riasingh2353/team27/docs/about.md

# Gathered close in tenuous firelight, and uneasy companionship.

Let me share with you the terrible wonders I have come to know...

[Home](./index.md)

## Felicia Guo
Felicia asked not to participate in D&D related about page descriptions.

[//]: # (As a level 10 ruiner of fun, Felicia is in the tomes of "Can you not?" and Loud Sighing. She embodies the spirit of the questing party, begrudgingly going along with the requirements of the ECE 3400 quest and the antics of her fellow adventurers.)
<br/>

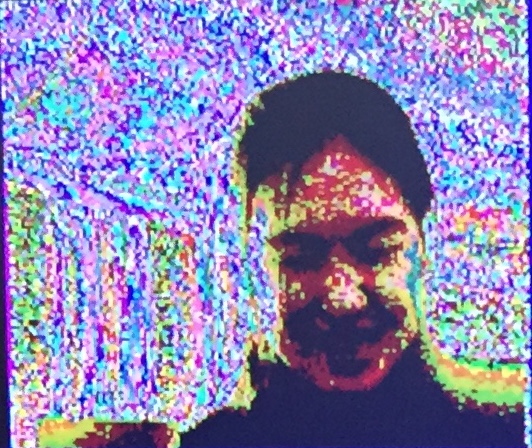
[picture p1: docs/media/about_us/felicia.png]
Felicia
 

## Michael Gong Rivera
NAME: MGGGGGGGGGGGGGGGGGG | ˈem-jēēēēēēēēēēēēēē<br/><br/>
CLASS & TITLE: Elf Sorcerer, ECE Folk Hero<br/><br/>
<!--[//]: # (STATS: Str: Thinks about going to the gym (+4) )
[//]: # (  Dex: 50 WPM (+1)  )
[//]: # (Con: 150lbs +- 10 (-2))
[//]: # (Int: Can this be negative (+pi)  ) 
[//]: # (Wis: Beyond his years (+20)   )
[//]: # (Cha: "unethusiastic...not very helpful...typically ask another TA who is more knowledgeable" (-6)<br/><br/>)
[//]: # (SPELLS: Long-winded Joke, "_Have heard of Stuyvesant?_", Talk to Self<br/><br/>)
[//]: # (FEATURES & TRAITS: Nocturnal, Sarcasm, Masochist, Lack of Impulse Control, Basic Taste<br/><br/>)
[//]: # (WEAKNESSES: Try literally roast, it'll probably stick)
-->
<br/>

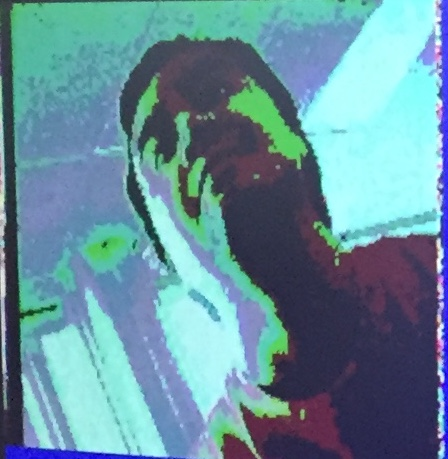
[picture p2: docs/media/about_us/michael.png]
Michael
 

## Ria Singh

<!--[//]: # (For the following, description requires background music to set the ambience.<br/>)
[//]: # (Please open a new tab and play "Duck, Duck, Goose" by Cupcakke (Rated R)<br/>)
[//]: # ((Aside: Don't actually play the song. You'll think less of us afterwards)<br/>)
[//]: # (Don't worry, I'll wait.<br/>)
[//]: # (Ready?<br/>)
[//]: # (Ok.<br/>)
[//]: # (Ria is a wandering bard searching for anyone willing to listen to her shittalk her companions. From objectively the worst state in the country, New Jersey, her abilities include laughing at the anything, as everything is apparently funny. Always one to lighten the hearts of her fellow travelers in times of stress, Ria embodies the mantras of memeing. Whether it be yelling at inanimate objects or forgetting to turn on the power supply, )
-->
Ria always manages to roll a perfect 20 on a d6 and temporarily improve the constitution of her party members by 2.
<br/><br/>
<!--Please finish listening to the song and then consider your life decisions)-->

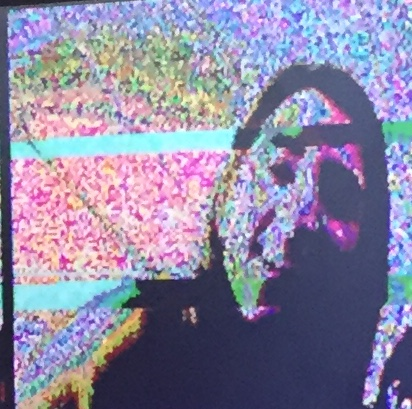
[picture p3: docs/media/about_us/ria.png]
Ria
 

## Ben Taussig

Ben is an elder lich, spawned during the Neoproterozoic Era and skilled in necromancy and aquakinesis. Neglect his warnings at your peril.

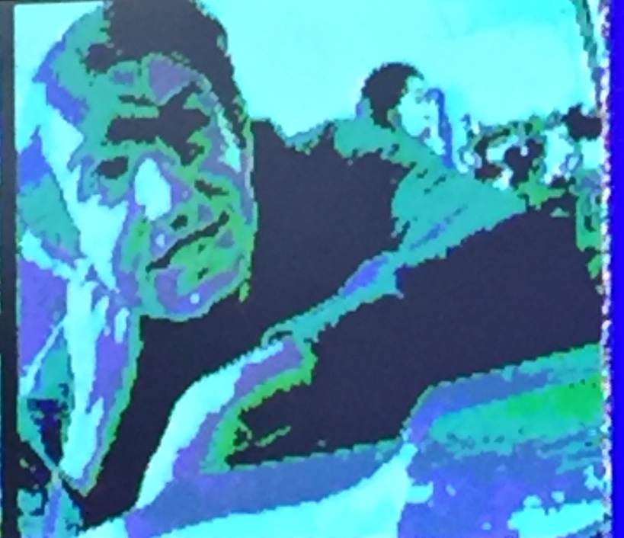
[picture p4: docs/media/about_us/ben.png]
Ben
 

## Ian Power

<!--[//]: # (Ian Power can be described as the diva of the group, the Scary Spice of the respective Girls.  He's fiercly independent, but never fails to be the star of the show.  Nevertheless, even when times get tough and the Cart has been gutted to find a loose wire, he can keep his head on his shoulders and remaining steadfast, like the steady Libyan coast that sheltered Aeneas' crew from Hera's watery wrath.)
-->
<!--
[//]: # (Ian Power is credited with robot documentation on the website, out-of-pocket R&D expenses (currently totalling $4620),)
[//]: # (and paying off TAs to sabotage other teams' cameras in order to pressure Kirstin to push back lab deadlines.  He currently holds the titles of Lead SysAdmin, Supreme Schematic-meister, and the Party Minstrel.  His special skills include playing the Trumpet, uphill skiing, and playing the numbers round in the UK gameshow Countdown.)
-->

Ian Power has never been to Canada, and doesn't believe it really exists.

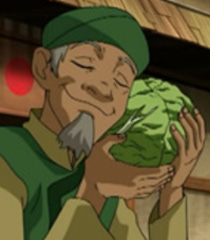
[picture p5: docs/media/about_us/cabbage_man.png]


## Zabiba
<!--[//]: # (A nightmarish creature beyond the control of its creators.)-->

Special Ability: Force all players to make a sanity roll on a d2.
<!--[//]: # (If successful, survive the semester, but receive +10 stress. On failure, cry and change major to CS.)-->

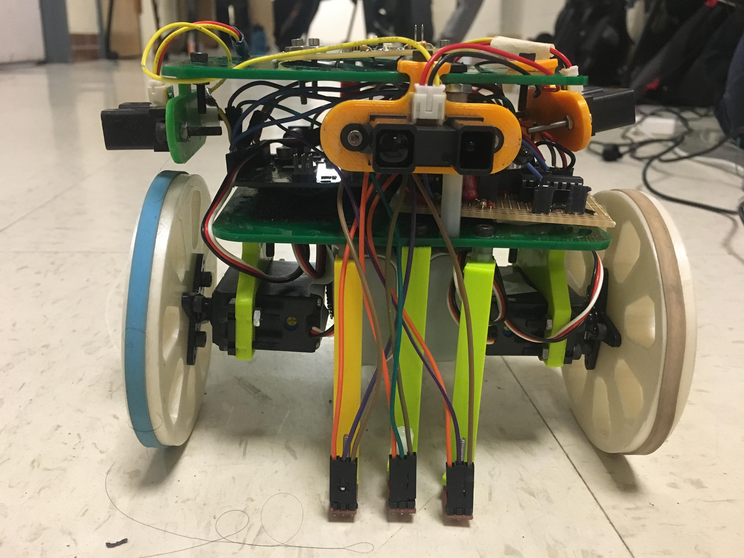
[picture p6: docs/media/final_design/final_design.png]
Final


<br/>
I hope these words steel your convictions for the trials to come.<br/>
Yours Truly,<br/>
-The Narrator
