riasingh2353/team27/Code/milestone3/animation (1).gif

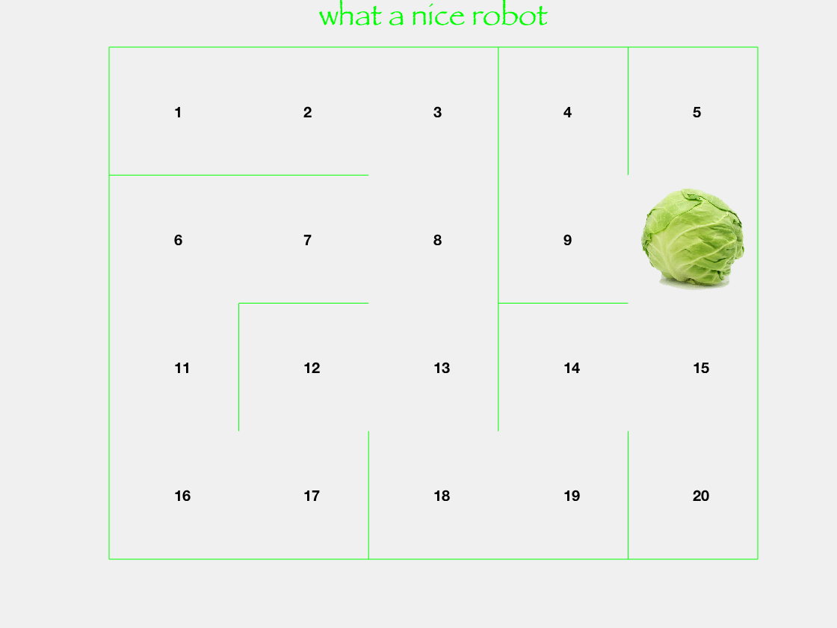
Code/milestone3/animation (1).gif
