riasingh2353/team27/docs/media/analog_read.png

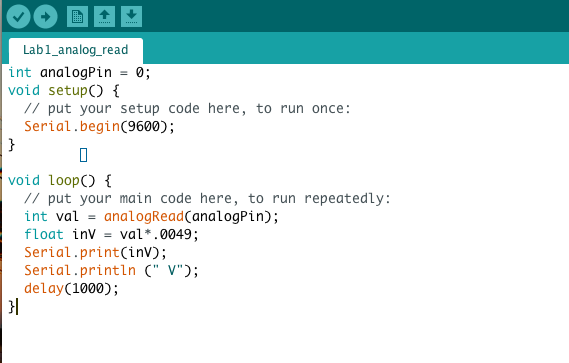
docs/media/analog_read.png
