riasingh2353/team27/docs/media/blink_loop.png

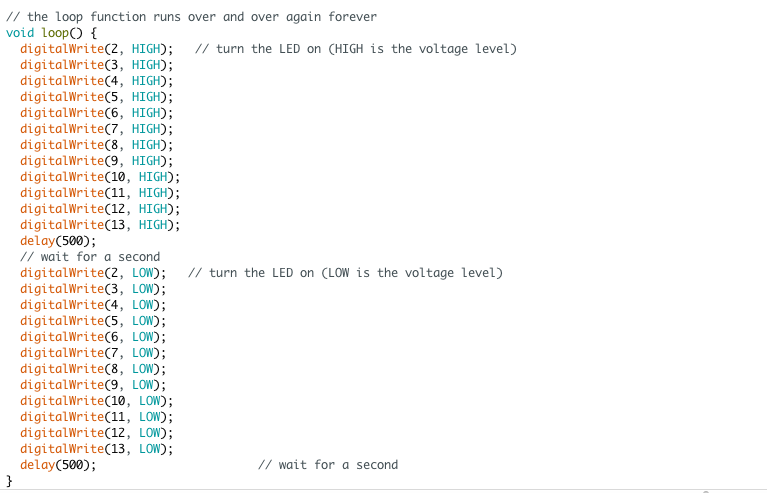
docs/media/blink_loop.png
