riasingh2353/team27/docs/media/FRONTOFROBOT.jpg

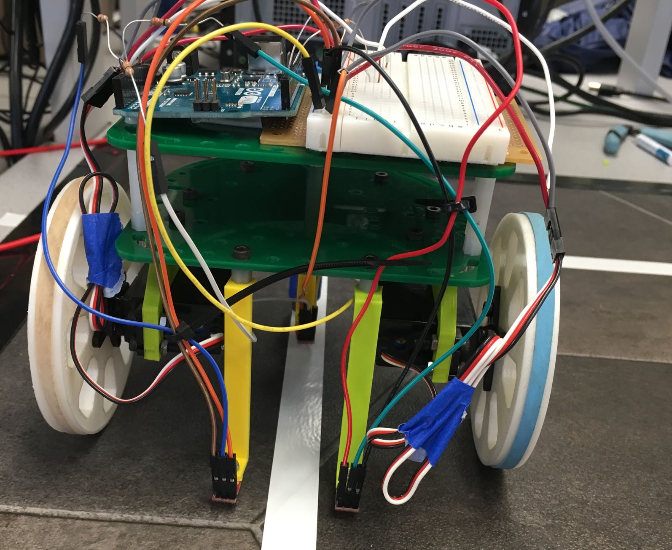
docs/media/FRONTOFROBOT.jpg
