riasingh2353/team27/docs/media/group_pic.png

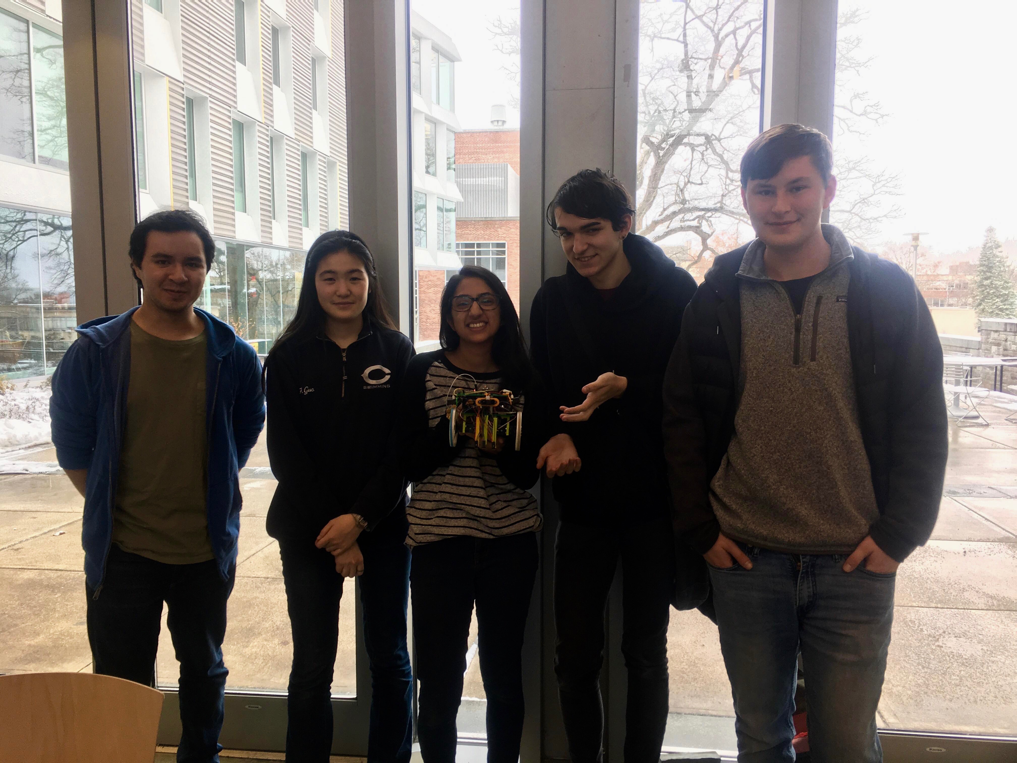
docs/media/group_pic.png
