riasingh2353/team27/docs/media/IMG_2586.PNG

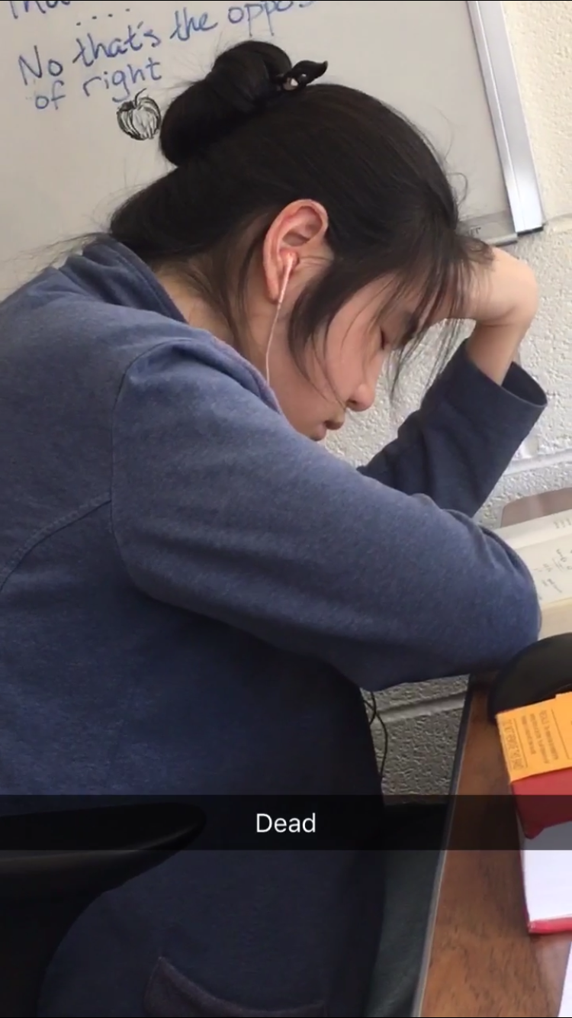
docs/media/IMG_2586.PNG
