riasingh2353/team27/docs/media/IRChart.PNG

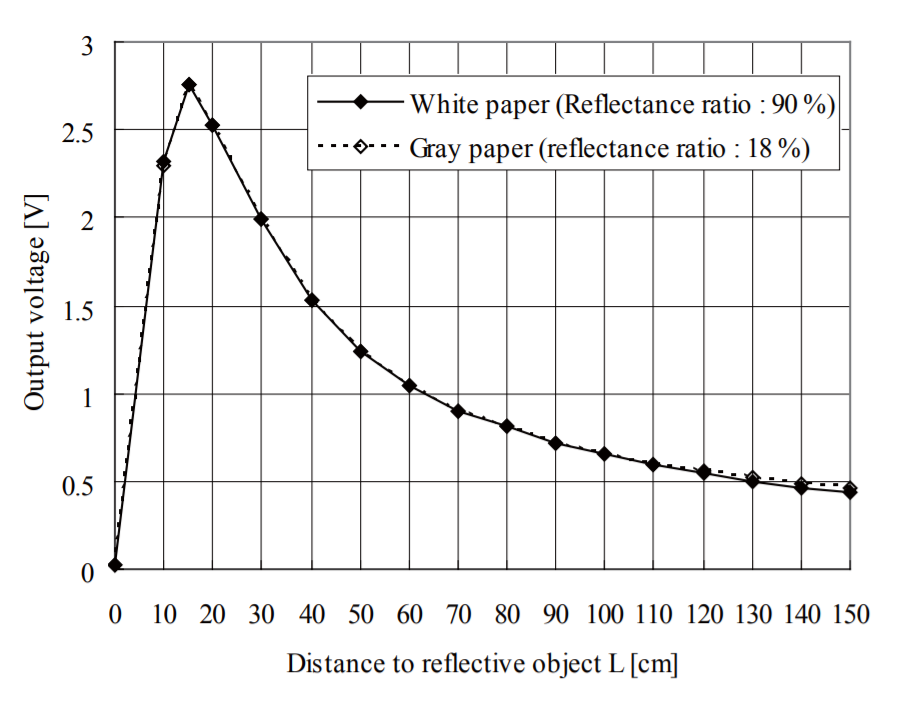
docs/media/IRChart.PNG
