riasingh2353/team27/docs/media/lab2/18khz.png

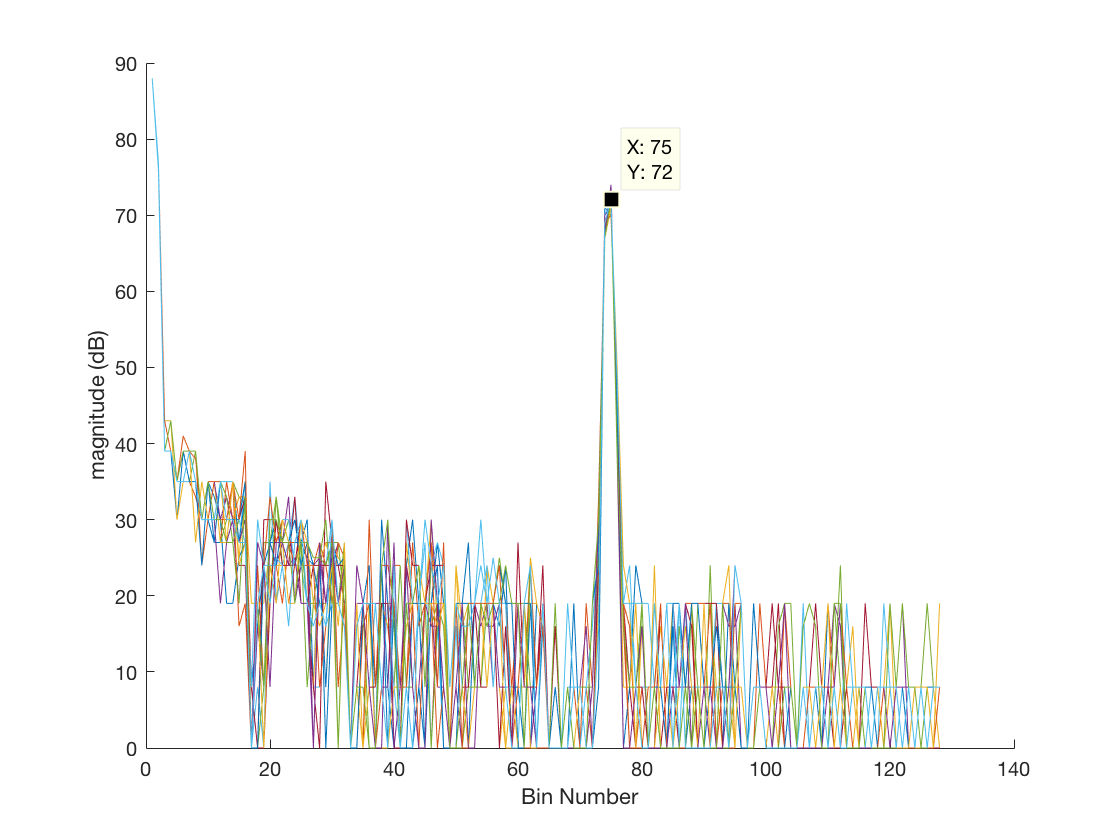
docs/media/lab2/18khz.png
