riasingh2353/team27/docs/media/lab3/Screenshot of radio working properly.png

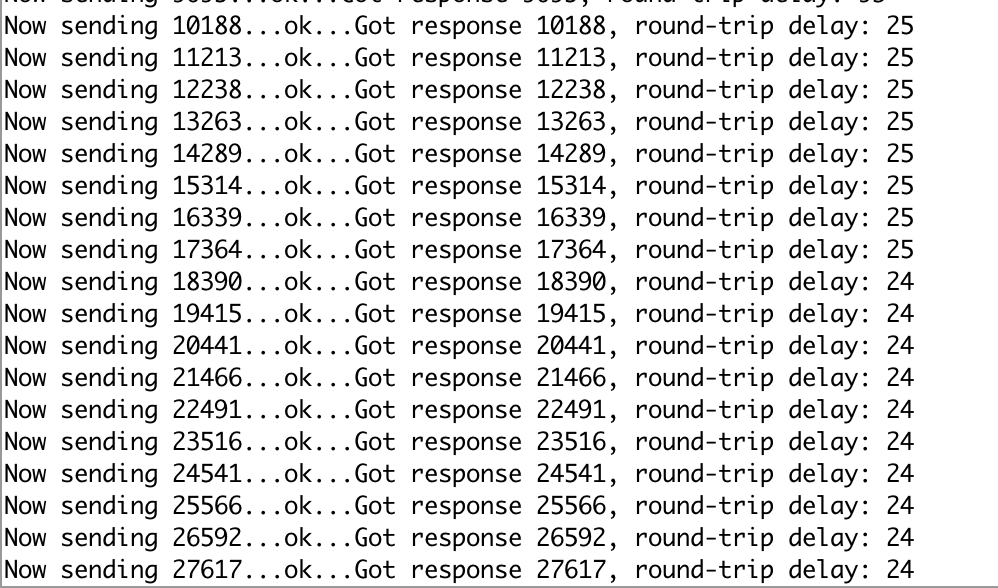
docs/media/lab3/Screenshot of radio working properly.png
