riasingh2353/team27/docs/media/lab4/RGB555.PNG

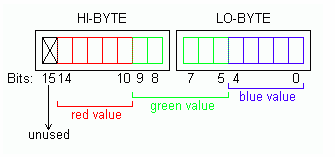
docs/media/lab4/RGB555.PNG
