riasingh2353/team27/docs/media/original_blink.png

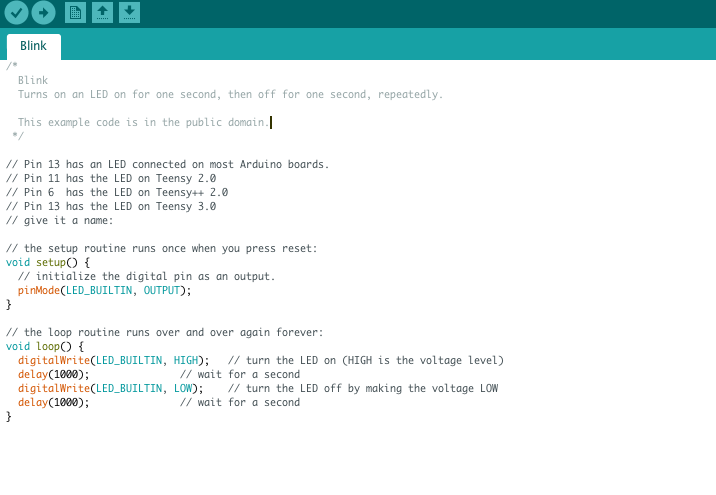
docs/media/original_blink.png
