riasingh2353/team27/docs/media/PWM.png

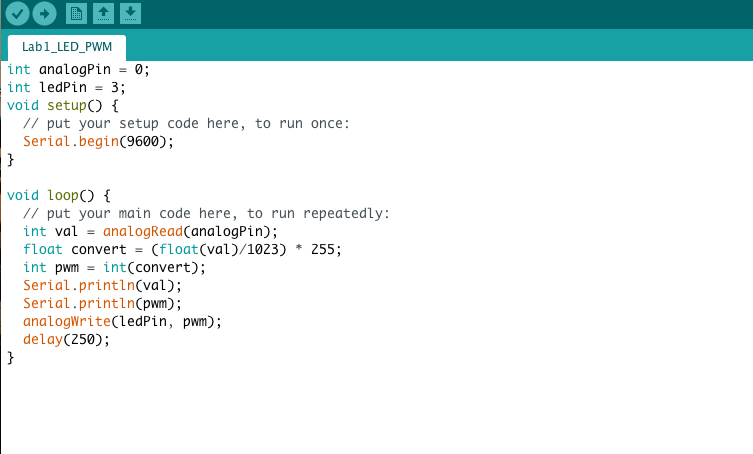
docs/media/PWM.png
