riasingh2353/team27/docs/media/blink_setup.png

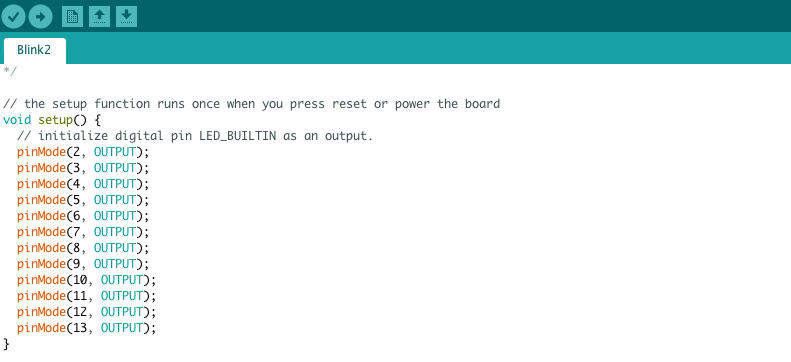
docs/media/blink_setup.png
