riasingh2353/team27/docs/media/PotentiometerSetup.png

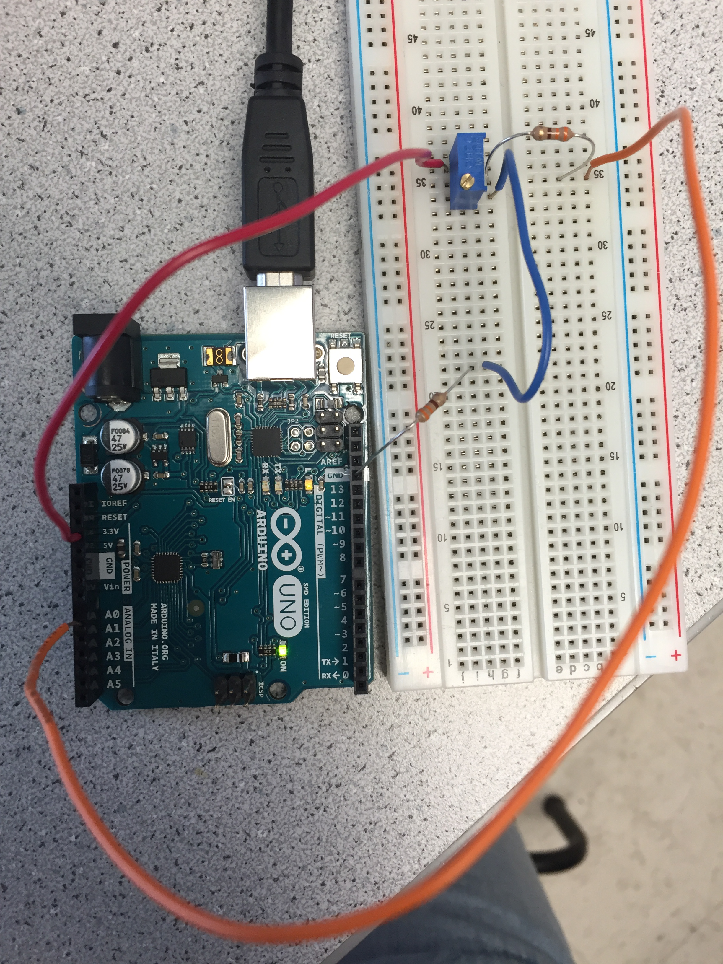
docs/media/PotentiometerSetup.png
