riasingh2353/team27/Code/Milestone 1/line_follow_hard_code/line_follow_hard_code.ino

#include <Servo.h>

Servo servoL;
Servo servoR;
int lastError = 0;
int Lspeed = 100;
int Rspeed = 80;
int adj = 0;
unsigned int sensor_values[2];
int countdown = 12;
int turn_num = 0;
int cutoff = 300;

void setup() {
// put your setup code here, to run once:
Serial.begin(9600);
servoL.attach(3);
servoR.attach(9);

}

// left, right, right, right, right, left, left

void loop() {

// put your main code here, to run repeatedly:
    sensor_values[0] = analogRead(A0);
    sensor_values[1] = analogRead(A1);
      
      if (sensor_values[0] > cutoff && sensor_values[1] > cutoff) { 
                //drive straight
          drive_straight();
        //Serial.println("DRIVING STRAIGHT !!!!!");
      }//if robot veers left
      else if (sensor_values[0] < cutoff && sensor_values[1]<cutoff) {
        Serial.println("Intersection!");
       /* switch(turn_num){
          case 0: turn_left();
          case 1: turn_right();
          case 2: turn_right();
          case 3: turn_right();
          case 4: turn_right();
          case 5: turn_left();
          case 6: turn_left();*/
         drive_straight();
        
        
        /*turn_num += 1;
        if (turn_num == 7){
          turn_num = 0;*/
        
        
      }
      else if (sensor_values[0] < cutoff) { //if robot veers right
        //veer left 
        veer_right();
        //Serial.println("VEERING LEFT !!!!!");
      }
      else {
        //veer right
         veer_left();
        //Serial.println("VEERING RIGHT !!!!!");
      }
      
      delay(500);
      Serial.println("LEFT:");
      Serial.println(sensor_values[0]);
      Serial.println("RIGHT:");
      Serial.println(sensor_values[1]);
      //make tolerance 50?
      //Serial.println(diff);
      
}

void veer_left(){
        servoL.write(125);
        servoR.write(88);
}

void veer_right(){
        servoL.write(80);
        servoR.write(55); 
}

void turn_left(){
        servoL.write(87);
        servoR.write(55);
        Serial.println("LEFT!");
        delay(600);

}

void turn_right(){
        servoL.write(125);
        servoR.write(93); 
        Serial.println("RIGHT!");
        delay(600);
        
}

void drive_straight(){
        servoL.write(120);
        servoR.write(60);
        
}
