riasingh2353/team27/(commit log)

2018-09-06 added wiring images to folder
2018-09-07 described on board blink
2018-09-07 blinking LED documentation
2018-09-07 analog and digital leds
2018-09-07 Home button
2018-09-13 added third sensor to figure 8 code
2018-09-14 included info about sensor output
2018-09-25 FFT script. Runs fast enough to detect optical signal
    The ADC runs ~eight times faster than default in this code. See detailed explanation here: http://www.gammon.com.au/adc . Otherwise, this code is essentially the same as the team alpha-based code used by the audio subteam.
2018-10-11 added right sensor code to wall detect
2018-10-19 may or may not work
    [Lab3_transmit.ino]
2018-10-20 Changed some digital pins
    Right servo now uses digital pin 5
    Wall sensor mux select uses digital pin 1
    Right wall detect LED uses pin 7
2018-10-20 robot should start at 660 HZ now. got rid of argument in fft_detect()
2018-10-21 Last version before including left wall sensor in turn logic
2018-10-21 Implemented left wall sensor in intersection logic + created helper function intersection()
2018-10-21 fixed some syntax errors. still need to fix pack_intersection_info
    [lab3_drive_code_new.ino]
2018-10-21 fixed some formatting issues
    [lab3_drive_code_new.ino]
2018-10-21 fixed weird merge issues
    [lab3_drive_code_new.ino]
2018-10-30 So arduino team doesn't have to resetup
2018-11-01 tried to test FPGA arduino data transfer
2018-11-08 changed camera setup
2018-11-08 pushed new camera code
2018-11-09 updated camera code
2018-11-16 final version of camera setup
2018-11-29 camera update for ease
